bjthemost-hub/l103-drv8316c-joint/gearbox-J/J_ratio25/00_assembly.step

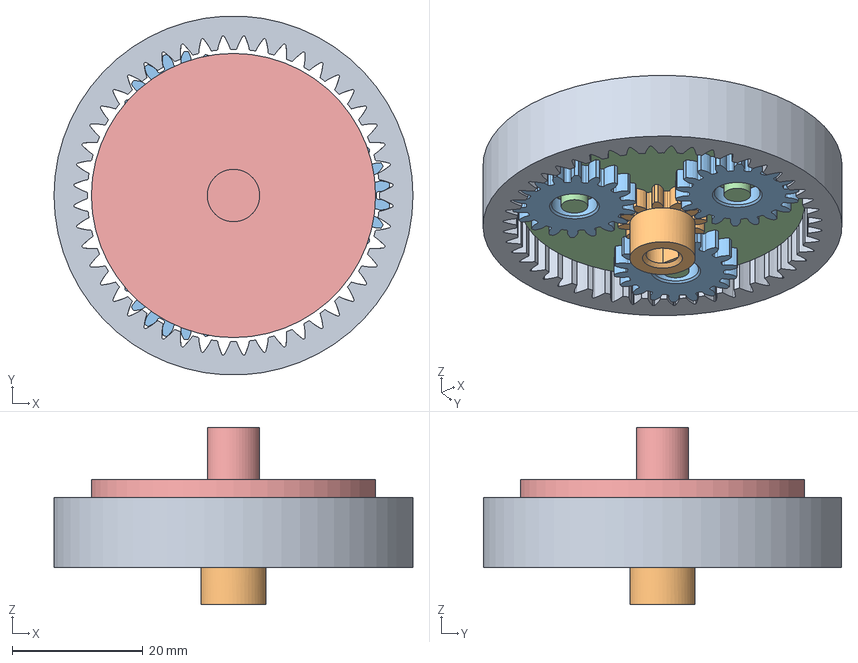
[picture p2: CAD file, 2026-10-27]
gearbox-J/J_ratio25/00_assembly.step
54.8 x 54.7 x 27.1 mm
