bjthemost-hub/l103-drv8316c-joint/gearbox-J/J_ratio25/03_input_sun.step

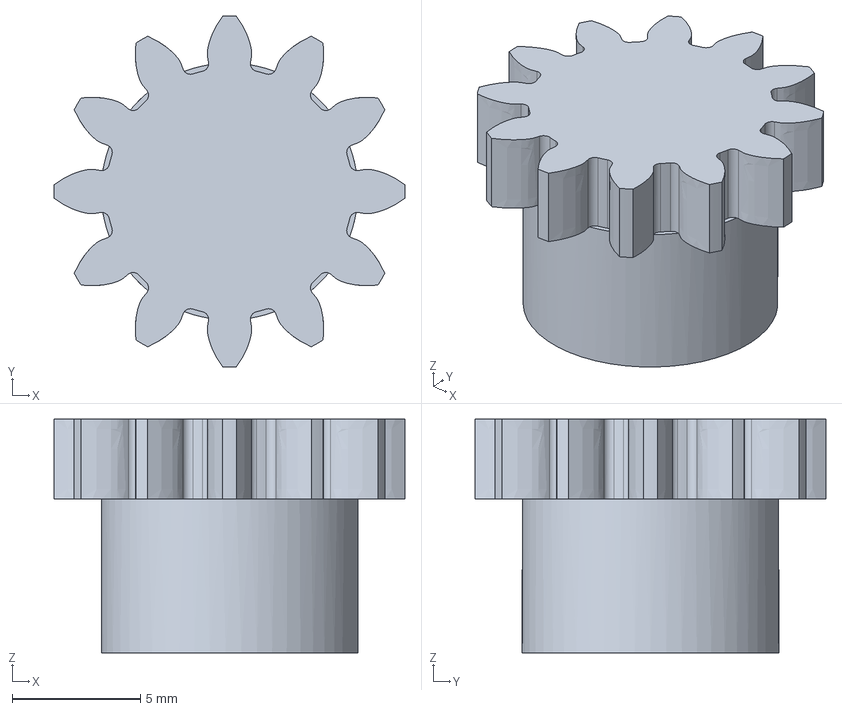
[picture p3: CAD file, 2026-10-27]
gearbox-J/J_ratio25/03_input_sun.step
13.7 x 13.7 x 9.10 mm
