bjthemost-hub/l103-drv8316c-joint/gearbox-J/J_ratio25/02_planet_gear.step

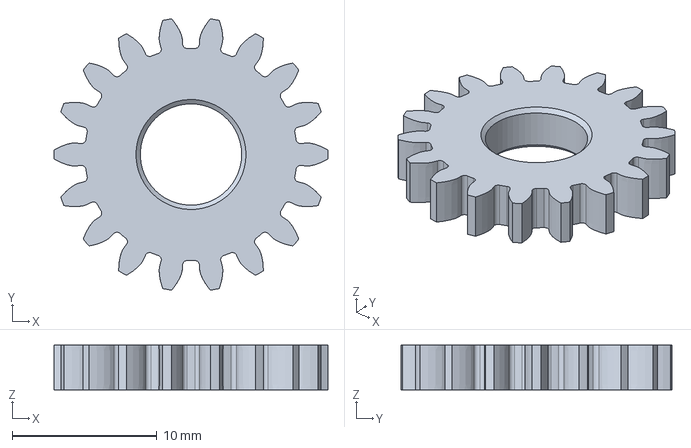
[picture p4: CAD file, 2026-10-27]
gearbox-J/J_ratio25/02_planet_gear.step
18.9 x 18.7 x 3.10 mm
