bjthemost-hub/l103-drv8316c-joint/gearbox-J/J_ratio25/01_ring_gear.step

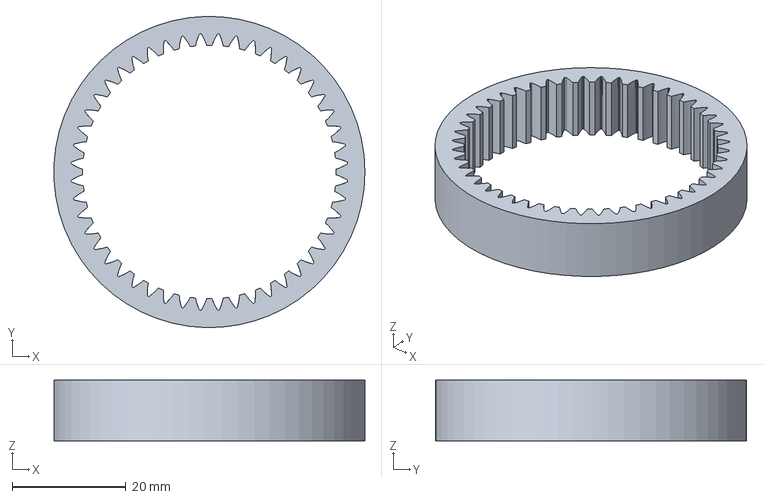
[picture p5: CAD file, 2026-10-27]
gearbox-J/J_ratio25/01_ring_gear.step
54.8 x 54.8 x 10.7 mm
