bjthemost-hub/l103-drv8316c-joint/gearbox-J/J_ratio25/05_output_carrier.step

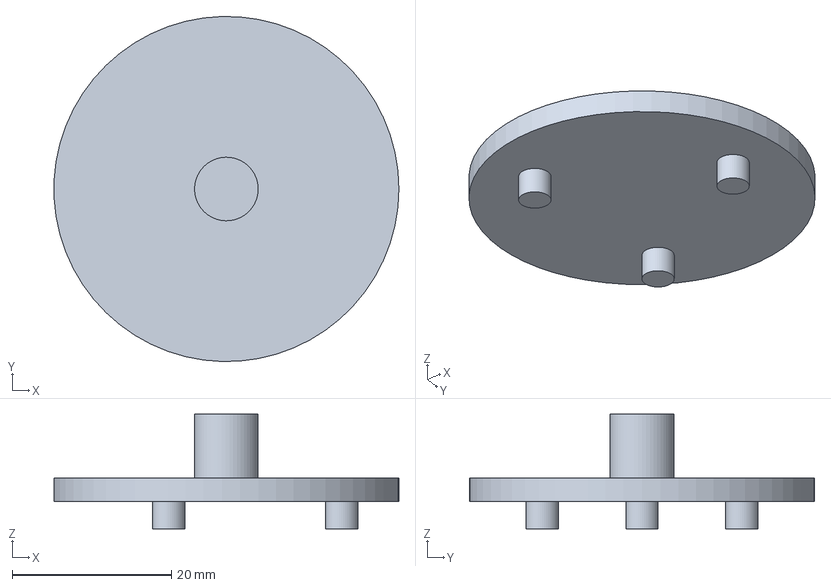
[picture p7: CAD file, 2026-10-27]
gearbox-J/J_ratio25/05_output_carrier.step
43.4 x 43.4 x 14.4 mm
