bjthemost-hub/l103-drv8316c-joint/docs/低速FOC调试方法与坑_2026-10-18.md

# 低速 FOC 调试方法与坑

**L103 + DRV8316C FOC V2 实战记录｜2026-10-18**

> **给谁看**：接下来要调另外 3 款驱动板的人（也可能是三个月后的自己）。
> **怎么用**：先看 §0 和 §10；动手照 §4 的顺序走；卡住了查 §7 的坑表。
> **可信度**：文中每个数字都来自 `firmware/CH32L103_DRV8316C_FOC_V2/work/` 下的原始采样 log，
> 用 `scripts/` 里的脚本可以原样复算（索引见 §11）。
> **一句话**：低速"顿"这次不是靠调 PID 蒙出来的，是**把 MT6701 的原始计数当尺子**量出来的。
> 尺子一立，根因（速度环吃错了反馈）20 分钟就露出来了。

---

## 0. 结论先行（3 分钟读完这段就够开工）

**这块板的成绩**（MT6701 原始计数，稳态段）：

| 给定 | 实测 | 100 ms sd | 100 ms 峰峰 | 零位移采样 | 回退 | 判定 |
|---|---|---|---|---|---|---|
| 3.8 rpm | 3.8 | 13.8% | 52.5% | 8.2% | 9 | 勉强，能看不能交 |
| 6.7 rpm | 6.6 | 14.5% | 47.5% | 2.1% | 1 | 勉强 |
| 10 rpm | 10.0 | 9.6~10.9% | 42.5% | 0.3~0.6% | 0 | **可用**（纹波大但不断流） |
| 30 rpm | 30.0 | 1.8~2.1% | 8.3~9.5% | 0% | 0 | 干净 |
| 60 rpm | 60.0 | 2.1% | 7.5% | 0% | 0 | 干净 |
| 100 rpm | 100.0 | 0.9~1.1% | 3.2~4.3% | 0% | 0 | 干净 |
| 200 rpm | 200.0 | 0.3% | 1.1% | 0% | 0 | 干净 |
| 300 rpm | 300.0 | 0.1~0.2% | 0.5~0.6% | 0% | 0 | 干净 |
| 500 rpm | 499.8 | 0.2% | 0.6% | 0% | 0 | 干净 |
| 700 rpm | 700.0 | 0.2% | 0.8% | 0% | 0 | 干净 |

**30 rpm 是分水岭**：≥30 rpm 全部干净；10 rpm 可用但纹波 40% 峰峰；<7 rpm 开始出现零星回退。

**三条纪律**（违反任何一条，这轮工作就白做）：

1. **判平滑只能用传感器原始数据**，不能用固件里的 `vel` —— 那是估计值，它坏了照样显示得像在工作。
2. **每次只改一个变量**：反馈源 → PLL 带宽 → 速度环 kp → ki，按这个顺序，别一起改。
3. **数字要留下**：每组参数存一份原始采样 log，文件名带转速+时长+反馈源。事后能拿同一套脚本复算。

---

## 1. 基线配置（新板从这套起步，但 §9 里写着哪些不能抄）

| 项 | 本板取值 | 怎么定的 |
|---|---|---|
| 速度反馈源 | **只用 PLL**（`vel_src=1`，命令 `VS1`） | 20 ms 窗口那一路把"停→冲"的阶梯喂给速度环，见坑 3 |
| PLL 带宽 | **150 Hz**（`PB150`） | 40/70/150/220/300 逐档量，见 §6.2 |
| 速度环 `kp` | **0.05 A/(rad/s)** | 0.02→0.04→0.05→0.06→0.07 扫，0.07 直接发散 |
| 速度环 `ki` | **4.0 A/(rad/s·s)** | 0.2→0.5→1→2→3→4→6→8 扫，6 开始重回退，8 发散 |
| 电流上限 `L` | 1.0 A | 家人定的工况：峰值 1.9 A 只是标称，秒级不进超过 1 A |
| 相电阻 `CUR_R_OHM_DEF` | 4.2 Ω | 3.0 V 稳态相电流 0.71 A 反算 |
| 对齐电压 | 3.0 V | 1.5 V 只挪 0.01 rad（不够），4.0 V 已 0.96 A（太贴上限） |
| 极对数 | **11**（MY-4621F，24N22P = 22 极 = 11 极对） | `Q` 里 `pp=11`；`T` 两次做差反推也核过 |
| 母线 | 24 V | —— |

**开环 vs 闭环对照（同一台机、同一转速 10 rpm）**：

| 跑法 | 每 100 ms 位移 | 零位移采样 | 回退 |
|---|---|---|---|
| 开环 1.833 Hz（跳闸前那 1.2 s） | 242~307 count（8.86~11.24 rpm） | 3.8% | 0 |
| 闭环 最终参数 | —— | 0.3~0.6% | 0 |

**读法**：闭环现在**比开环还干净**。这条对照很关键 —— 它证明电机、编码器、驱动、机械都没问题，
后面再怀疑就只能怀疑环路。

---

## 2. 为什么必须用原始计数当尺子（本次最大的收获）

### 2.1 `vel` 会骗人，而且骗得很像真的

修之前，`?` 里的 `vel` 显示 1.0~1.15 rad/s，看着稳；**实际原始位置是走走停停**：

同一段 10 rpm 记录（`work/cap10_p02k20.log`，4.98 s，2497 个 2 ms 样本）：

- **56.0% 的 2 ms 采样零位移**（相邻两个样本 raw 计数完全一样）
- **145 次回退**（2 ms 计数差 < 0，即真的往回走了）
- 100 ms 窗口速度在 **-1.8 ~ +8.1 rad/s** 之间甩
- 100 ms 窗口 sd = 1.19 rad/s，相对 9.0 rpm 的均值是 **126.5%**

`vel` 之所以看着正常，是因为它是 PLL/窗口算出来的**估计值**：PLL 在"停-冲"之间照样能输出一条平滑曲线。
估计值坏了不会报错，只会让你以为已经调好了。

### 2.2 开环对照：这一步别省

同一台机、开环 1.833 Hz 跑 10 rpm（`work/cap10_ol1833.log` 的前 600 个样本 = 1.2 s）：

- 零位移 3.8%（600 个采样里 23 个）
- 回退 0 次
- 2 ms 计数差分布：`0:23 1:24 2:13 3:22 4:61 5:111 6:138 7:129 8:62 9:15 10:1`
  —— 峰在 5~6，两边递减，是正常的样子

**同一台机、开环干净、闭环顿** → 锅在环路，不在齿槽、不在摩擦、不在驱动。
没有这个对照，很容易把问题归到"电机齿槽大 / 机械有摩擦"，然后白折腾一天。

⚠ 这份 log 很容易被误读：**整段**打分是 76.5% 零位移、1 次回退 —— 因为开环跑到 1.2 s 时过流跳闸了，
后面 3.8 s 电机是停的。**必须只取跳闸前那段**。这就是 §3.4 口径问题的活教材。

### 2.3 量化地板：低速端的 sd 有一个算得出来的下限

编码器 14 位 = 16384 count/圈，采样 2 ms：

```
1 count / 2 ms = (2π/16384) / 0.002 = 0.1917 rad/s = 1.83 rpm
```

也就是说，**低速端的"1 个 count 抖动"本身就有 1.83 rpm 的份量**。
10 rpm 时这一份就占 18%，再怎么调 PID 也压不掉 —— 想再往下走，只能提高采样率或换更细的编码器，
不是靠加增益。（这是算术，不是实测。）

这解释了 §0 表里 10 rpm 的 9~11% sd 为什么怎么调都下不去：**分母太小了**。
实测也能对上：10/100/300 rpm 的**绝对** sd 都在 0.11 rad/s 上下，10 rpm 时占 11%、300 rpm 时只占 0.4%。

---

## 3. 尺子怎么架（这套工具建议原样搬到新板）

### 3.1 固件侧：500 Hz 原始角直出（命令 `SD1`）

在**编码器更新**里每 20 帧抽一个 14 位原始计数（10 kHz / 20 = **2 ms**），主循环按
`<seq>,<raw>`（两个十六进制）发出去。**不经过 PLL、不经过窗口测速、不做任何滤波。**

- 开关：`SD1` 打开 / `SD0` 关闭
- 格式：`<seq 12 位>,<raw 14 位>`，每行一个样本，`\r\n`，例：`FA9,1F90`
- 实测体积：1999 个样本 = 19114 字节 → **约 9.6 B/样本，4.8 KB/s**
  （115200 8N1 = 10 bit/字节 ≈ 11.5 KB/s，占用约四成，够用）
- `seq` 是**必须的**：主循环跟不上会丢样，`seq` 跳变立刻暴露，不会把丢样误当成"速度突变"
  - ⚠ `seq` 只有 12 位，**会回绕**（0xFFF → 0x000）。判丢样要按 `(后-前) mod 4096` 算，别直接相减。

实现要点（见 `firmware/CH32L103_DRV8316C_FOC_V2/User/enc.c` 的 `cap_*`）：

1. 捕获点放在 **CRC 校验通过之后** —— 坏帧不进流，否则会把坏帧当作真实抖动。
2. 抽取计数放在**编码器更新里**，不要放主循环 —— 主循环会被 printf 拖慢，节拍就不准了。
3. 主循环只做"有新样本就打印"，不排队、不缓存，丢就丢 —— `seq` 会告诉你丢了多少。
4. 开 `SD` 时先 `SD0` 清一次，避免上一次的残留在缓冲里。
5. **别在 SD1 期间发别的命令**：命令回显会混进数据流，解析会多出杂行（脚本已按正则只认 `hex,hex`）。

### 3.2 上位机侧：一条命令 = 一次测量

```powershell
cd firmware\CH32L103_DRV8316C_FOC_V2
# 给定 1.047 rad/s (=10 rpm), 采 5 s, 存 work\m10.log; 默认测完自动 M0
powershell -ExecutionPolicy Bypass -File scripts\measure.ps1 -Vel 1.047 -Ms 5000 -Out work\m10.log
python scripts\scorecap.py work\m10.log
```

`measure.ps1` 干的事：开串口 → （可选）补发 `-Pre "PB150;S0.05,4.0"` → `SD0` → `V<速度>` → `M3`
→ 等 `-SettleMs`（默认 900 ms）→ `SD1` → 截 `-Ms` → `SD0` → `M0` → 落盘。

⚠ 本机 PowerShell 的执行策略挡住了 .ps1，一律用 `powershell -ExecutionPolicy Bypass -File ...`。

**特别提醒**：`-SettleMs` 只等你 900 ms，**不要把这个数当成"已经稳了"**，
打分默认取尾部（见 §3.4）就是为了避开这段。

### 3.3 四个指标 + 判据

| 指标 | 为什么看它 | 好 / 坏 |
|---|---|---|
| **零位移采样占比** | 直接反映"停没停" | <1% 好；>10% 就是顿 |
| **回退次数**（2 ms 计数差 <0） | 抖到倒转 | 0 次才算干净 |
| **100 ms 窗口速度 sd / 峰峰** | 中频纹波 | sd<2% 好；低速端 >10% 常见 |
| **2 ms 计数差分布** | 看台阶 | 应集中在中位数附近，两边递减 |

单个样本的 2 ms 计数差分布是最能说明问题的一张表：正常是"钟形"，一压增益就变成"0 一堆 + 大数一堆"。

### 3.4 口径三条（这三条踩过，别重踩）

1. **别把爬升段算进指标**。同样 10 rpm：含爬升的 6 s 记录 sd 37.5%，只取后 4 s 稳态是 10.9%。
   `scorecap.py` 取后 5 s，`cmp_tail.py` 默认取尾部；要精确控制就 `python scripts\score_seg.py <log> <起> <止>`。
2. **跳闸/掉线的尾巴会把整段毁掉**。开环那次整段 76.5% 零位移，前 1.2 s 其实只有 3.8%。
   看到离谱的数字，先 `python scripts\trace100.py <log>` 每 100 ms 打印一行，肉眼扫一遍。
3. **文件名带转速+时长+反馈源**。本次 `caponly.ps1` 写死输出名，第二次抓 10 rpm 把第一份覆盖了。
   现在统一用 `-Out work\<含义>.log`。

**脚本清单**（都在 `firmware/CH32L103_DRV8316C_FOC_V2/scripts/`）：

| 脚本 | 用途 |
|---|---|
| `measure.ps1` | 一次测量（定速→M3→SD1→截 N ms→停） |
| `ser.ps1` | 裸串口发命令看回显，例：`-Cmds "?;Q;" -Ms 700` |
| `scorecap.py` | 一次出全部指标（尾部 5 s） |
| `cmp_tail.py` | 多文件对比：25/50/100 ms 三档 + 主导脉动频率 |
| `score_seg.py` | 指定样本区间打分（含 2 ms 差分布） |
| `analyze_cap.py` | 通读：丢样数、总位移、计数差分布 |
| `trace100.py` | 每 100 ms 一行，肉眼看波形 |
| `rndrun.ps1` | 随机转速 × 随机时长批量跑 |
| `trialcap.ps1` | 按 `反馈源:kp:ki[:PLL带宽]` 逐组跑并落盘 |
| `sweepcap.ps1` | kp/ki 组合扫描 |

---

## 4. 调试顺序（新板第一次上电就照这个走）

**第 0 步之前先量三个数**，它们决定后面的天花板：编码器分辨率（CPR）、极对数、母线电压、
相电阻（用直流注入法量）。这几个数不知道，后面所有"调不好"都无从判断。

1. **桥断电**：`CZ` 标三相电流零点（此时不许出力）。
2. **电流符号/相序**：`CS<0|1|2>,<±1>` 只在实测错的时候改；三相电流和 `sum` 应≈0。
3. **编码器自检**：`Q` 看 `err=0 crc=0`；手转一圈看 `raw` 连续、`pp` 对不对。
4. **极对数**：`PP<n>`；不放心用 `T` 两次做差反推。错了对齐全废。
5. **对齐**：`A`，看 `al=1`；对齐电压从 3.0 V 起（本板）。
6. **开环第一步**（家规：上板第一步一律开环）：`R<volt>,<hz>`，从 **0.2~0.5 Hz** 起。
   - 用 `SD1` 量一遍平滑度，**记下这台机的"机械天花板"基线**（本板 10 rpm：零位移 3.8%、回退 0）
   - ⚠ 开环电压给高了会**真实过流跳闸**（本板 3.0 V / 1.83 Hz 跑到 1.2 s 时 `flt=1`）；`X` 清故障
7. **速度环**：`VS1` → `PB150` → `S0.05,0.50` 起步 → 按 §1 的顺序加到 `ki=4.0`
8. **扫速**：10 / 30 / 100 / 300 / 700 rpm 各跑 3~5 s，全部用 `SD1` 打分
9. **看电流**：`iq` 峰值和 `imax` 都要远低于 1 A

**命令语义（已核源码，别凭上一块板的记忆发）**：

- `M0`=OFF `M1`=ALIGN `M2`=TORQUE `M3`=VELOCITY `M4`=POSITION `M5`=OPENLOOP
- `V` 给 **rad/s**；`W` 是速度上限（**会偷偷夹给定**）
- 位置模式要**先进 `M4` 再发 `P`**（切模式会把 `pos_cmd` 改写成当前位置）

---

## 5. 这次实际怎么走过来的（流水账，按时间）

时间为 `work/` 下脚本与 log 的文件时间戳（不是对话时间）。**这段是最值钱的**：
它说明"调不动"的时间里，大部分根本不是 PID 的问题。

| 时间 | 干了什么 | 看到什么 | 结论 / 教训 |
|---|---|---|---|
| 14:08~14:37 | 备份 `csense.c`/`enc.c`，做 NOP 实验，反汇编，首次烧写 | —— | 先把"改前的样子"存下来，后面每一步都能回退 |
| 15:14~15:35 | 备份 `board.h`，用 Python 写定点模型（`model_foc_fx2/3.py`）算增益余量 | —— | **先算再试**：定点位宽/溢出边界在 PC 上算清楚，别拿板子试 |
| 15:45~15:59 | `clk.ps1`/`baud.ps1`/`pp*.ps1`/`rate*.ps1` 核时钟、串口速率、极对数 | 串口 460800 不稳，退回 115200 | 下载器自带 UART 到不了 460800（见坑 16） |
| 16:02~16:24 | `patch_cc4`/`cssign`/`qdir`/`alignwatch`/`olspin`/`spdwatch`/`tqprobe`/`tqt` | 对齐、开环、力矩逐个探 | 每个功能单独一个小脚本验证，别一锅端 |
| 16:30~16:42 | `patch_span`/`patch_win`/`fix_coef`/`guard.ps1` | —— | 加了"护栏"脚本，跑实验前先确认状态 |
| 16:49~16:57 | 加原始捕获流 + **修 PLL 无符号除法**（`fix_pll_unsigned.py`） | 修前：一使能 `pos` 狂涨、`th` 几乎不动 | 坑 1 |
| 17:00~17:04 | **速度环积分器 Q12→Q16**（`fix_spd_integ.py`）+ 落默认值 + `bench_*` 四组 | 修前：给速度，`iq` 只有 0.01 A，电机纹丝不动 | 坑 2 |
| 17:06~17:08 | `sw10_*` kp/ki 扫描（此时还是窗口反馈） | 怎么调都是"走-停"，降到 kp0.005 也只是变慢 | 直觉是"增益不够"，其实是**反馈源坏了** |
| 17:10~17:13 | 加 `SD1` 原始角直出（`patch_cap.py`）+ `cap10_p02k20` / `cap10_ol1833` | 闭环 56.0% 零位移 / 145 回退；开环 3.8% / 0 回退 | **尺子立起来**，锅锁定在环路 |
| 17:13~17:15 | 加 `VS`/`PB` 在线切换（`patch_vsrc.py`），`vs10_*` / `pb10_*` | `VS2` 窗口：-0.48 rpm、938 回退；`VS1` PLL：9.82 rpm、0 回退 | **根因确认**（坑 3） |
| 17:16~17:19 | `r10*` / `r30*` / `r100*` / `k30*` / `k100*` ki 扫描 | ki 4.0 最优；6 开始重回退；8 发散 | 定 `ki=4.0`（§6.3） |
| 17:20 | `final_10/30/100` 复测 | 三档全干净 | 落默认值 |
| 19:39~19:46 | `cap_v045/300/700` + `rnd_*` 随机 12 段 | 全档位、随机时长复测 | 交卷 |

**一句话**：从 14:00 到 17:10 都在修**上电就错**的东西（PLL 除法、积分器精度、反馈源），
真正的 PID 调参只有 17:16~17:20 **四分钟**。下次先照 §4 的顺序把"地基"验一遍，
不要一上来就调 PID。

---

## 6. 参数扫描全表（全部可复算）

口径统一：`scorecap.py` 取**尾部 5 s**；`sd100` 是 100 ms 窗口速度的**绝对**标准差（rad/s）。
"sd100 %"= 绝对 sd ÷ 该段平均速度。

### 6.1 反馈源（10 rpm，kp0.02 / ki0.20 / PB150）

| 反馈 | 平均 rpm | 零位移 | 回退 | sd100 | 判定 |
|---|---|---|---|---|---|
| `VS2` 只窗口 | **-0.48** | 12.6% | **938** | 10.94 | 完全不行（均值都拉负了） |
| `VS1` 只 PLL | 9.45 | 22.3% | 0 | 0.72 | 不顿，但增益太小跟不上 |
| `VS1` + kp0.05/ki0.50 | 9.82 | 2.3% | 0 | 0.31 | 可调 |
| `VS1` + kp0.10/ki1.00 | 0.13 | 0.2% | **1256** | 0.53 | 增益过大，直接失速 |

### 6.2 PLL 带宽（10 rpm，kp0.05 / ki0.50）

| `PB` | 平均 rpm | 零位移 | 回退 | sd100 |
|---|---|---|---|---|
| 40 | 9.94 | 16.1% | 537 | 0.55 |
| 70 | 9.96 | 4.7% | 86 | 0.29 |
| **150** | 9.90 | **0.3%** | **0** | 0.30 |
| 220 | 9.85 | 0.1% | 0 | 0.31 |
| 300 | 9.95 | 0.1% | 0 | 0.30 |

**读法**：70 以下明显退化；**150 已经到位**；220/300 回退是 0 但 sd 没再降 —— 多给的带宽不换收益，
反而更容易把噪声引进环路。所以取 150 留余量。

### 6.3 ki 扫描（10 rpm，PB150）

| kp / ki | 平均 rpm | 零位移 | 回退 | sd100 | 备注 |
|---|---|---|---|---|---|
| 0.04 / 1.0 | 9.91 | 0.2% | 0 | 0.33 | |
| 0.06 / 0.8 | 9.91 | 0.2% | 0 | 0.26 | |
| 0.05 / 0.5 | 9.82 | 2.3% | 0 | 0.31 | 起点 |
| 0.05 / 1.0 | 10.02 | 0.0% | 0 | 0.26 | |
| 0.06 / 1.2 | 9.91 | 0.8% | 0 | 0.24 | |
| 0.05 / 1.5 | 10.00 | 0.0% | 0 | 0.21 | |
| 0.05 / 2.0 | 9.97 | 0.0% | 0 | 0.19 | |
| 0.05 / 3.0 | 9.93 | 0.2% | 0 | 0.15 | |
| **0.05 / 4.0** | 9.99 | 0.5% | **0** | **0.11** | **落这档** |
| 0.05 / 6.0 | 9.94 | 5.3% | **176** | 0.08 | sd 更好但**开始重回退** |
| 0.05 / 8.0 | 9.16 | 7.0% | **855** | 0.63 | 发散 |

**这张表里最重要的一行是 ki=6.0**：它的 sd（0.08）比 4.0（0.11）**还小**。
只盯 sd 会选错 —— **必须同时看回退次数**。低频抖动被压平了，代价是每 2 ms 里有零星倒转。

### 6.4 换转速交叉验证（30 / 100 rpm）

| 转速 | ki0.5 | ki2.0 | ki4.0 |
|---|---|---|---|
| 30 rpm sd100 | 0.17 | 0.08 | **0.06** |
| 100 rpm sd100 | 0.18 | 0.15 | **0.11** |

ki=4.0 在 30 和 100 rpm 上也是最优 —— 说明这个值不是为 10 rpm 单独凑出来的。

### 6.5 kp 的上边界（10 rpm，PB150）

| kp / ki | 平均 rpm | 零位移 | 回退 | 判定 |
|---|---|---|---|---|
| 0.05 / 0.35 | 9.79 | 2.6% | 1 | 积分不足 |
| 0.05 / 0.70 | 9.90 | 2.9% | 7 | 积分不足 |
| 0.06 / 0.50 | 9.93 | 5.0% | 64 | kp 偏大 |
| **0.07 / 0.60** | **-0.47** | 8.5% | **937** | **发散** |

kp 的边界很窄：0.06 已经能看出退化，0.07 直接翻车。**调的时候一次只加 0.01。**

### 6.6 随机复测 12 段（整段口径，含爬升）

| 文件 | 给定 | 实测 | 时长 | 零位移 | 回退 | sd100 | 峰峰 |
|---|---|---|---|---|---|---|---|
| rnd_12 | 3.8 rpm | 3.8 | 1.61 s | 8.2% | 9 | 13.8% | 52.5% |
| rnd_11 | 6.7 | 6.6 | 3.54 s | 2.1% | 1 | 14.5% | 47.5% |
| rnd_09 | 10 | 10.0 | 4.61 s | 0.3% | 0 | 9.6% | 42.5% |
| rnd_10 | 30 | 29.9 | 2.29 s | 0% | 0 | 2.1% | 8.7% |
| rnd_03 | 30 | 30.0 | 3.11 s | 0% | 0 | 2.1% | 9.5% |
| rnd_01 | 60 | 60.0 | 3.62 s | 0% | 0 | 2.1% | 7.5% |
| rnd_05 | 100 | 100.0 | 2.96 s | 0% | 0 | 0.9% | 3.2% |
| rnd_04 | 200 | 200.0 | 4.58 s | 0% | 0 | 0.3% | 1.1% |
| rnd_07 | 300 | 299.8 | 2.22 s | 0% | 0 | 0.1% | 0.5% |
| rnd_08 | 300 | 300.0 | 4.82 s | 0% | 0 | 0.2% | 0.6% |
| rnd_06 | 500 | 499.8 | 2.56 s | 0% | 0 | 0.2% | 0.6% |
| rnd_02 | 700 | 700.0 | 4.92 s | 0% | 0 | 0.2% | 0.8% |

同一转速跑两个不同时长（30 rpm 2.29 s / 3.11 s、300 rpm 2.22 s / 4.82 s），结果一致 —— 可复现。

---

## 7. 坑（症状 → 怎么定位 → 根因 → 修法 → 新板怎么预防）

> 前三条是**会让人调一整晚**的；每条都写了"换板时凭什么能提前发现"。

### 坑 1：PLL 预测步长用了无符号除法（最隐蔽）
- **症状**：静止一切正常，一使能 `pos` 狂涨、`th` 几乎不变。
- **定位**：`pos` 在涨但电角度不动 → 直接去看 PLL 那几行，把中间量打出来看符号。
- **根因**：`ENC_TICK_HZ` 是 `unsigned`，`pll_vel_q24 / ENC_TICK_HZ` 整段变成**无符号除法**；
  速度为负时除法结果反向，位置每拍跳 +0.0256 圈，PLL 速度被推到 ±128 圈/s 的天花板。
- **修法**：整段改 `int64`，除数写成 `(int32_t)ENC_TICK_HZ`；两处 PLL 校正乘法也改 `int64`
  （`err` 钳到 2^18 时 int32 会溢出）。
- **新板预防**：把 PLL 的三行拿计算器代几个负数进去算一遍。**混合有符号/无符号的除法是静默炸弹**。

### 坑 2：速度环积分器精度不够，电机干脆不动
- **症状**：给速度，`vel` 一直是 0，`iq` 只有 0.01 A 左右，电机纹丝不动。
- **定位**：`iq` 有值但极小 → 说明环路在算，只是算出来不够大 → 查积分器位宽。
- **根因**：积分器用 Q12，`ki*ts` 每拍增量被右移截成 0（`ki=0.3` 时 5 s 后 `iq` 仍 0.01 A）。
- **修法**：积分器 Q12 → **Q16**，输出 `>>4`。
- **新板预防**：定点化时**先算"最小增量还剩几个 LSB"**，别等现场怀疑电机坏了。

### 坑 3：低速用 20 ms 窗口测速当反馈，速度环只能压到很低，一压就"走走停停"（本次主犯）
- **症状**：10 rpm 时 56.0% 采样零位移、145 次回退；把增益降下来只是把"冲"变小，"停"还在。
- **定位**：加 `VS0/1/2`（自动/PLL/窗口）**在线切换**，同一台机同一转速对打：
  `VS2` 窗口 = -0.48 rpm / 938 回退；`VS1` PLL = 9.82 rpm / 0 回退。
- **根因**：窗口值 20 ms 才更新一次（ZOH 再加 20 ms 延迟），还被 0 计数台阶拉低；
  速度环看见的是"停→冲"的阶梯，只能把 kp 压到 0.02、ki 压到 0.2 —— 压低了就必然顿。
- **修法**：速度环默认只用 PLL（`vel_src=1`），窗口只留作诊断。
- **新板预防**：**先量反馈通路的延迟和量化，再调 PID**。延迟决定你能用多大增益，不是反过来。

### 坑 4：`W`（速度上限）在偷偷夹你
- **症状**：`V31.416` 回 `OK vel_cmd=31.416`，但 `ref vel` 一直是 1.05，转速上不去。
- **根因**：之前为了跑 200 圈设了 `W1.047`，速度环把给定夹到 `vel_limit`，**回显不提示**。
- **修法**：`W330`（或按需）放开；调高速前**先看 `ref vel` 是不是等于给定值**。
- **新板预防**：所有"回显正确但行为不对"的，先怀疑**另一个隐形的上限**（限流/限速/限位）。

### 坑 5：位置模式一切进去就把目标改成"当前位置"
- **症状**：先 `P<目标>` 再 `M4`，位置环进去了但一动不动，`ref vel=0`。
- **根因**：运行中切模式时，`motor.c` 里把 `pos_cmd = 当前角度`（防跳变的安全设计），
  把你刚发的目标**覆盖**了。
- **修法**：**先进 `M4`，再发 `P<目标>`**。
- **新板预防**：换板先看一遍"切模式"那段代码 —— 那里一定藏着会吃掉你给定的逻辑。

### 坑 6：模式编号跟老固件不一样
- **本板**：`M0`=OFF、`M1`=ALIGN、`M2`=TORQUE、`M3`=VELOCITY、`M4`=POSITION、`M5`=OPENLOOP。
- **老固件（CH32L103_DRV8313）**：`M0` 力矩 / `M1` 速度 / `M2` 角度 / `M3` 速度开环 / `M4` 角度开环。
- **教训**：**发 `M<n>` 前先看 `mode_name()` / 枚举**，别凭上一块板的记忆发。本次就误发过一个 `M2`（力矩）。

### 坑 7：开环电压给高 → 真过流跳闸，别误判成硬件坏
- **症状**：开环跑 1.2 s 后突然停住，`flt=1/1`、`mode=OFF`。
- **根因**：`MOTOR_OC_TRIP_A=2.0` 触发，`latch_fault` 关桥。
- **修法**：`X` 清故障；开环用更低电压/更短时间做对照。
- **教训**：**开环不是"安全模式"**，它一样能烧东西；开环只看"能不能转、平不平"，别久跑。

### 坑 8：`?` 里的 `vel` 会骗人
- 见 §2.1。**永远用原始计数交叉验证**，至少在做"平滑度"结论的时候。
- 补充：**同一路反馈不算独立证据**。PLL 值和窗口值"吻合"证明不了位置对，因为两者同源。

### 坑 9：诊断计数器是"自上次清零以来"的
- `Q` 里的 `recon`、`csync`、`enc frames` 是累计量；跑过高速之后再去跑低速，这些数会把两段混在一起
  （本次出现过 `recon=167787` 被误读）。
- **修法**：要对比就先复位，或者只信两次 `Q` 之间的**增量**。

### 坑 10：串口 "Access denied" 先查是不是自己的进程没退
- 中断一次批量脚本后，`COM15` 被残留进程占着，第二次打开就 `Access to the port is denied`。
- **做法**：先列 `powershell` 进程确认，别一上来怀疑下载器/板子。

---

### 坑 11：采集窗口含爬升段，指标全假
- **症状**：同一组参数两次打分差 3~4 倍（37.5% vs 10.9%）。
- **根因**：一段 6 s 的记录里前 2 s 是爬升。
- **修法**：`scorecap.py` 默认取尾部 5 s；要不留余地就 `score_seg.py <log> <起> <止>` 自己切。
- **新板预防**：**先 `trace100.py` 看一遍再信指标**。一眼能看出哪段是爬升、哪段是停。

### 坑 12：跳闸/掉线会把整段 log 毁掉
- **症状**：开环 10 rpm 的 log 整段打分 76.5% 零位移，看着像"根本转不动"。
- **真相**：前 1.2 s 只有 3.8%，后面 3.8 s 是跳闸停机。
- **修法**：`trace100.py` 找到停机时刻，用 `score_seg.py` 只取有效段。
- **新板预防**：**每次采集后先看尾部**。尾部长时间 0 就是跳闸或掉线，别拿去比参数。

### 坑 13：采样文件重名，把不同转速的数据混了
- **症状**：回头比"两次 10 rpm"发现结论对不上。
- **根因**：本次 `caponly.ps1` 写死了输出名，第二次抓 10 rpm 时覆盖了 0.45 rad/s 的那份。
- **修法**：文件名带**转速 + 时长 + 反馈源**，例如 `rnd_03_v3.142_3120ms.log`；
  现在统一走 `measure.ps1 -Out work\<含义>.log`。
- **新板预防**：**写死输出名的脚本就是定时炸弹**，第一次用就参数化。

### 坑 14：`seq` 12 位回绕，直接相减会误判成"丢了 4000 个样"
- **症状**：数据流里 `FFF` 后面接 `7C7`，一眼像丢了近 2000 个样本。
- **真相**：`seq` 只有 12 位，0xFFF 之后回绕到 0x000。按 `(后-前) mod 4096` 算才是真丢样数。
- **新板预防**：凡是"序号"字段，先确认位宽和回绕规则，再写丢样检测。

### 坑 15：抽帧放主循环 / 坏帧没滤掉
- **症状**：低速数据看着"抖"，但换一版固件就没了。
- **根因**：主循环里有 printf，节拍被拖；或者 CRC 没过的坏帧也进了流。
- **修法**：抽帧放**编码器更新**里（10 kHz 定时源）；捕获点放 **CRC 通过之后**。
- **新板预防**：尺子本身不准，后面所有结论都是错的。**先证明尺子是直的**：
  静止时 raw 不动、手转一圈 raw 单调、丢样为 0。

### 坑 16：串口 460800 不稳，退回 115200
- **症状**：460800 下偶发乱码 / 收不全。
- **根因**：下载器自带的 UART 口不稳（不是 MCU 的问题）。
- **修法**：固件和上位机都退到 **115200**；`SD1` 的 4.8 KB/s 在 115200 下够用（约四成带宽）。
- **新板预防**：换板第一件事用 `baud.ps1` 之类**打一串固定文本对一遍**，别拿调试链路当示波器。

### 坑 17：`SD1` 期间发别的命令，回显混进数据流
- **症状**：解析脚本报"格式不对"，或者样本数对不上。
- **根因**：`OK ...` 之类的回显和 `<hex>,<hex>` 混在一起。
- **修法**：解析按 `^[0-9A-Fa-f]+,[0-9A-Fa-f]+$` 只认数据行（`scripts/*.py` 已经这么写）；
  采集期间不发别的命令。
- **新板预防**：数据流和回显**共用一个口**时，永远假设它们会打架。

### 坑 18：扫参数扫到"发散"才知道边界在哪
- **症状**：kp 0.06 看着还行，0.07 直接 -0.47 rpm / 937 回退。
- **教训**：**边界必须自己扫出来，不能靠猜**。且**一次只加一档**（kp 步长 0.01，ki 从 2 起步翻倍）。
- **另一个陷阱**：ki=6.0 的 sd 比 4.0 更小，但回退 176 次 —— **sd 单一指标会骗人**（§6.3）。

### 坑 19：母线电压不够，却去调环路
- **症状**：转速上不去，`vq` 顶到 12.7 V 附近然后 nFAULT。
- **真相**：`Ke ≈ 0.083 V/(rad/s)`（由 12.7 V / 153 rad/s 反推），314 rad/s 要 ~26 V，
  24 V 母线上不去 3000 rpm。**这是电压不够，不是环路问题**。
- **新板预防**：换板先算一遍"我这母线最多能到多少 rpm"，把这个数写在纸上贴显示器上。

### 坑 20：低速端的 sd% 天生就大，别拿同一个阈值卡所有转速
- 10/100/300 rpm 的**绝对** sd 都在 0.11 rad/s 上下，但相对值是 11% / 1% / 0.4%。
- **判据要分档**：≥30 rpm 用相对值（<2%）；<30 rpm 用绝对值和零位移占比。
- 根子在 §2.3 的量化地板。

---

## 8. 已知的物理天花板（别再往上撞）

- **24 V 母线到不了 3000 rpm**：跑到 ~153 rad/s 时 `vq` 已顶 12.73 V 并报 nFAULT。
  由 `12.7 V / 153 rad/s` 反推 Ke ≈ 0.083 V/(rad/s)，314 rad/s 约需 26 V。**这里调环路没用，得升母线。**
- **10 rpm 以下有一份 ~0.11 rad/s 的固定速度纹波**：10/100/300 rpm 的绝对 sd 都是 0.11 rad/s 上下，
  10 rpm 时占 11%、300 rpm 时只占 0.4%。要再压得从**转矩脉动**下手（齿槽/角度滞后/电流环），
  继续加 PID 到 `ki=6` 就开始重回退。
- **高转速下 `vd` 会涨**：700 rpm 时 `vd=0.99 V / vq=6.56 V`，折算电角度滞后约 8.6°，
  白吃电流。再往高走要动 PLL 带宽或角度外推。
- **2 ms 采样 + 14 位编码器的量化地板 = 1.83 rpm**（§2.3），低速端所有指标都受它托底。

---

## 9. 换板清单：哪些能抄，哪些必须重测

### 9.1 直接抄（跟具体板子无关）

- **判据与工具链**：`SD` 原始直出 → `measure.ps1` → `scorecap.py` 四指标。整套照搬。
- **调试顺序**：§4 的 9 步。尤其"先开环做机械基线"这一步。
- **反馈源策略**：速度环**只用 PLL**，20 ms 窗口只留作诊断。
- **速度环积分器 Q16**（Q12 在低速会截断成 0）。
- **PLL 里的有符号除法**：整段 `int64`，除数转 `int32_t`。
- **"一次只改一个变量"的顺序**：反馈源 → PLL 带宽 → kp → ki。
- **口径**：尾部取稳态、看 2 ms 计数差分布、文件名带转速。

### 9.2 必须重测（每块板的数都不一样）

| 项 | 为什么不能抄 | 怎么量 |
|---|---|---|
| 速度环 kp / ki | 跟电机电感电阻、母线、电流环带宽、编码器分辨率全有关 | §6.3 / §6.5 的扫法，从 kp0.05 / ki0.5 起 |
| PLL 带宽 | 跟编码器 CPR 和采样率有关；CPR 低的板子给 150 Hz 可能就抖 | 40/70/150/220 各跑一遍 |
| 对齐电压 | 跟相电阻有关；太高直接过流 | 从 3.0 V 试，看转没转 + 电流 |
| 过流阈值 / I2t | 跟功率级和电机额定有关 | 按电机铭牌 + 实测温升 |
| 极对数 | 错了对齐全废 | `PP` + `T` 两次做差反推 |
| 电流零点 / 相序符号 | 每块板的采样电阻和相序都可能不同 | `CZ` + `CS` + 三相电流和≈0 |
| 电压天花板（最高 rpm） | 母线 × Ke 决定 | 升速到 `vq` 顶住或 nFAULT，记下那个点 |

### 9.3 移植时要动的三处代码

1. `User/enc.c` 的 `cap_*`：编码器中断里每 20 帧抽一个 raw，主循环打印 `<seq>,<raw>`。
   **捕获点必须在 CRC 通过之后**，抽帧必须在编码器更新里。
2. `User/enc.c` / `cmd.c`：`vel_src`（`VS0/1/2`）+ PLL 带宽（`PB<hz>`）—— 这两个开关是**调试期最重要的一对**，
   新板一开始就要有，不然又要靠"改固件重烧"来对比。
3. `User/board.h`：速度环默认 `kp/ki`、积分器 Q16。

### 9.4 三块板并行调的时候，别互相污染

- **一个板一个目录**，`work/` 下的 log 用板名/日期前缀，别混。
- 参数扫到一半就换板，**先把当前 log 存盘并把结论写回文档**，否则回来分不清哪组数属于哪块板。
- 每块板都留一份"机械基线"（开环 10 rpm 的零位移/回退），后面吵架时拿它当裁判。

---

## 10. 一页速查（打印出来贴墙上）

```
上电顺序:   CZ 零点 -> Q 查 err/crc -> PP 极对数 -> A 对齐 -> R 开环 0.2~0.5Hz
尺子:       SD1 (500Hz 原始角, 2ms)  |  measure.ps1 -Vel <rad/s> -Ms <ms> -Out work\x.log
打分:       scorecap.py <log>    看: 零位移% / 回退 / sd100 / 峰峰
判据:       >=30rpm: sd100<2%, 零位移<1%, 回退 0
            10~30rpm: 零位移<1%, 回退 0, sd100 看绝对值(~0.11 rad/s 是本板地板)
调参顺序:   反馈源(VS1) -> PLL带宽(PB150) -> kp(0.05 起) -> ki(0.5 起, 翻倍加到回退出现)
停下信号:   ki 一加就出现回退 -> 退回上一档; kp 0.07 级发散
安全:       秒级相电流 <=1A; 开环也会真过流; 位置模式先 M4 再 P
```

**判定一次调试"成了没有"**：零位移 <1%、回退 0、≥30 rpm 时 sd100 <2%。
三条不齐就是没成，别急着说"调好了"。

---

## 11. 证据在哪

- **本轮工作报告**：`firmware/CH32L103_DRV8316C_FOC_V2/docs/工作报告_2026-10-18_低速10-30-100rpm平滑化.md`
- **原始采样**：`firmware/CH32L103_DRV8316C_FOC_V2/work/` 下（**只在本地，不进 git**）
  - 主犯证据：`cap10_p02k20.log`（闭环 56% 零位移）、`cap10_ol1833.log`（开环对照）
  - 反馈源：`vs10_vs2_*`（窗口）vs `vs10_vs1_*`（PLL）
  - PLL 带宽：`pb10_*_pb40/70/150/220`、`r10b_*_pb300`
  - ki 扫描：`r10b/r10c/r10d/r10e_*`
  - 落默认后复测：`final_10/30/100rpm.log`、`cap_v045/300/700.log`、`rnd_01..12_*.log`
- **分析脚本**：`firmware/CH32L103_DRV8316C_FOC_V2/scripts/`（见 §3.4 的表）
- **命令表**：`firmware/CH32L103_DRV8316C_FOC_V2/docs/命令表.md`（含 `SD`/`VS`/`PB`）
- **固件改动**：`User/enc.c`（捕获流 + `vel_src` + PLL 定宽）、`User/enc.h`、`User/cmd.c`（`SD`/`VS`/`PB`）、
  `User/main.c`（直出）、`User/board.h`（`SPD_KP_DEF=0.05`、`SPD_KI_DEF=4.0`）

---

## 变更记录

- **2026-10-18 第一版**：调试完成当天写的骨架（结论表 + 11 条坑）。
- **2026-10-18 第二版（本版）**：为"马上要调另外 3 块驱动板"重写 —— 补 §5 流水账、§6 全部扫描数据、
  §2.3 量化地板、§9 换板清单；坑从 11 条扩到 20 条；脚本统一收进 `scripts/`，新增 `measure.ps1`
  （一条命令一次测量）。
