bjthemost-hub/l103-drv8316c-joint/hardware/L103_DRV8316C.kicad_pcb

## KiCad design hardware/L103_DRV8316C.kicad_pcb (2026-10-27)

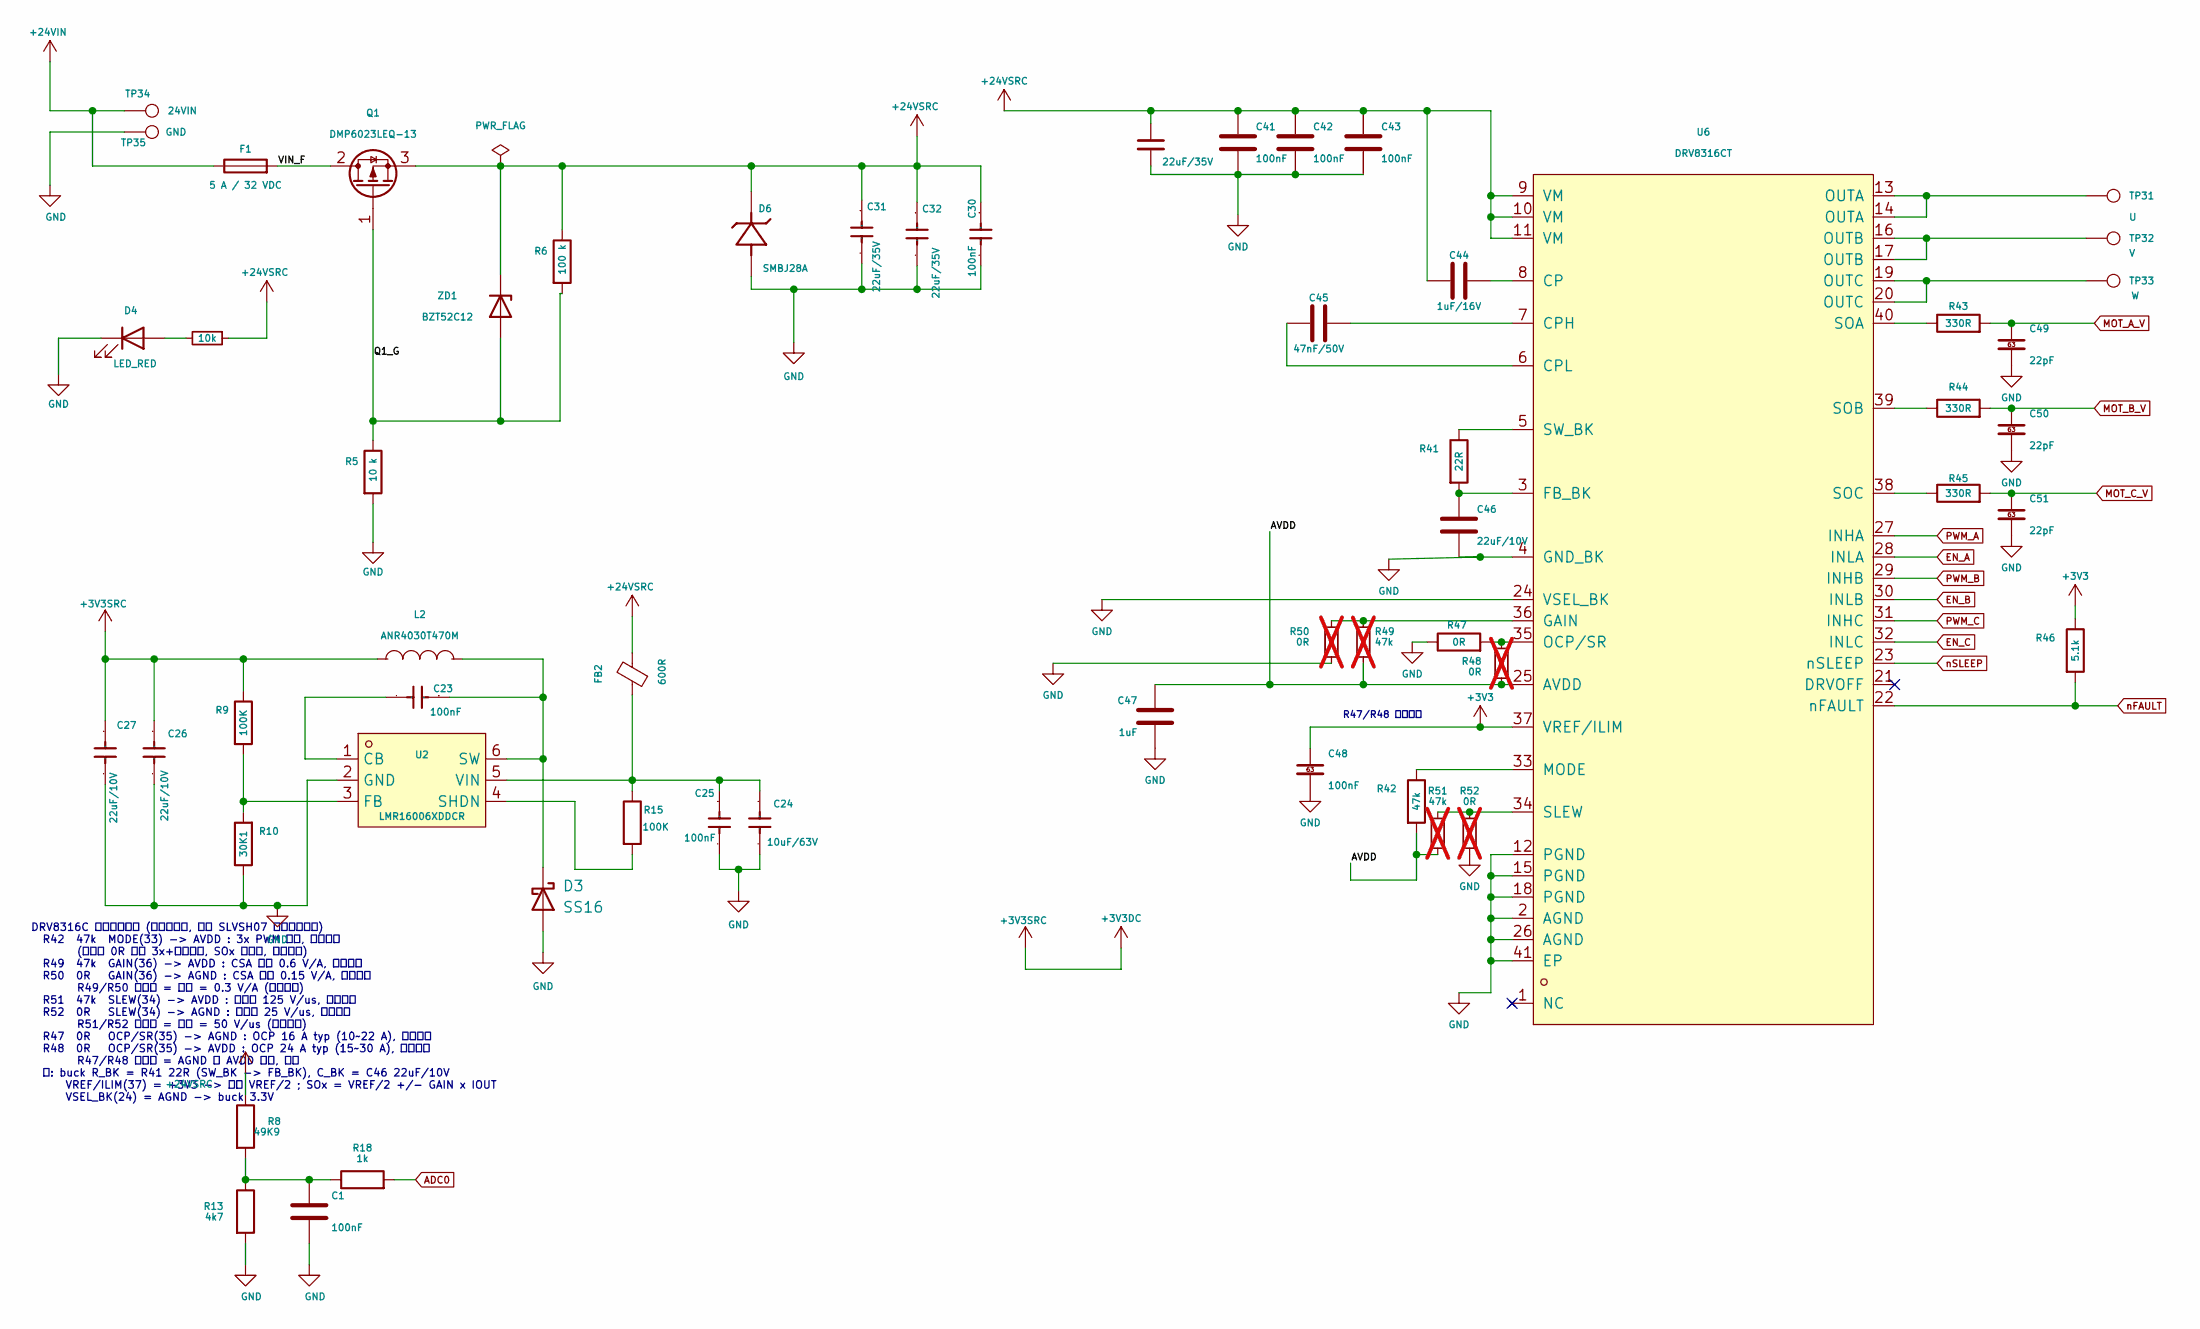
[picture p8: schematic DRV8316C.kicad_sch]

Parts:
C1, C23, C25, C30, C41, C42, C43, C48: 100nF; C_0603_1608Metric
C7, C31, C32: 22uF/35V; C_1206_3216Metric
C24: 10uF/63V; C_0805_2012Metric
C26, C27, C46: 22uF/10V; C_0805_2012Metric
C44: 1uF/16V; C_0603_1608Metric
C45: 47nF/50V; C_0603_1608Metric
C47: 1uF; C_0603_1608Metric
C49, C50, C51: 22pF; C_0603_1608Metric
D3: SS16; D_SMA
D4: LED_RED; LED_0603_1608Metric
D6: SMBJ28A; D_SMB; BREAKDOWN VOLTAGE 28.9V; MANUFACTURER PART SMBJ28A; LCSC PART NAME SMBJ28A
F1: 5 A / 32 VDC; Fuse_Littelfuse-NANO2-451_453
FB2: 600R; L_0805_2012Metric
L2: ANR4030T470M; L_APV_ANR4030; MPN ANR4030T470M; LCSC Part C6364808
Q1: DMP6023LEQ-13; SOT-223-3_TabPin2
R5: 10 k; R_0805_2012Metric
R6: 100 k; R_0805_2012Metric
R8: 49K9; R_0603_1608Metric
R9, R15: 100K; R_0603_1608Metric
R10: 30K1; R_0603_1608Metric
R13: 4k7; R_0603_1608Metric
R18: 1k; R_0603_1608Metric
R25: 10k; R_0603_1608Metric
R41: 22R; R_0603_1608Metric
R42: 47k; R_0402_1005Metric
R43, R44, R45: 330R; R_0603_1608Metric
R46: 5.1k; R_0603_1608Metric
R47: 0R; R_0402_1005Metric
R48, R50, R52: 0R; R_0402_1005Metric; not fitted
R49, R51: 47k; R_0402_1005Metric; not fitted
TP31: U; tp2.2x1.2_th
TP32: V; tp2.2x1.2_th
TP33: W; tp2.2x1.2_th
TP34: 24VIN; tp2.2x1.2_th
TP35: GND; tp2.2x1.2_th
U2: LMR16006XDDCR; SOT-23-6; MPN LMR16006XDDCR; LCSC Part C87080
U6: DRV8316CT; VFQFN-40_L5.0-W7.0-P0.50-TL-EP
ZD1: BZT52C12; D_SOD-123

Connections:
+3V3: C48.1, R46.1, U6.37 (VREF/ILIM); also elsewhere on the board
+3V3DC: C26.1, C27.1, L2.1, R9.1; also elsewhere on the board
+24VIN: F1.1, TP34.1 (1_1)
+24VSRC: C7.1, C30.1, C31.1, C32.1, C41.1, C42.1, C43.1, C44.1, D6.1 (K), FB2.2, Q1.3 (S), R6.1, R8.1, R25.1, U6.9 (VM), U6.10 (VM), U6.11 (VM), ZD1.1 (K)
/DRV8316C/AVDD: C47.1, R42.2, R48.2, R49.2, R51.2, U6.25 (AVDD)
/DRV8316C/Q1_G: Q1.1 (G), R5.1, R6.2, ZD1.2 (A)
/DRV8316C/VIN_F: F1.2, Q1.2 (D)
ADC0: R18.2; also elsewhere on the board
EN_A: U6.28 (INLA); also elsewhere on the board
EN_B: U6.30 (INLB); also elsewhere on the board
EN_C: U6.32 (INLC); also elsewhere on the board
GND: C1.2, C7.2, C24.2, C25.2, C26.2, C27.2, C30.2, C31.2, C32.2, C41.2, C42.2, C43.2, C46.2, C47.2, C48.2, C49.2, C50.2, C51.2, D3.2 (A), D4.1 (K), D6.2 (A), R5.2, R10.1, R13.2, R47.1, R50.2, R52.2, TP35.1 (1_1), U2.2 (GND), U6.2 (AGND), U6.4 (GND_BK), U6.12 (PGND), U6.15 (PGND), U6.18 (PGND), U6.24 (VSEL_BK), U6.26 (AGND), U6.41 (EP); also elsewhere on the board
MOT_A_V: C49.1, R43.2; also elsewhere on the board
MOT_B_V: C50.1, R44.2; also elsewhere on the board
MOT_C_V: C51.1, R45.2; also elsewhere on the board
unnamed: C1.1, R8.2, R13.1, R18.1
unnamed: C23.1, D3.1 (K), L2.2, U2.6 (SW)
unnamed: D4.2 (A), R25.2
unnamed: TP31.1 (1_1), U6.13 (OUTA), U6.14 (OUTA)
unnamed: TP32.1 (1_1), U6.16 (OUTB), U6.17 (OUTB)
unnamed: TP33.1 (1_1), U6.19 (OUTC), U6.20 (OUTC)
unnamed: C23.2, U2.1 (CB)
unnamed: R9.2, R10.2, U2.3 (FB)
unnamed: R15.2, U2.4 (SHDN)
unnamed: C24.1, C25.1, FB2.1, R15.1, U2.5 (VIN)
unnamed: C44.2, U6.8 (CP)
unnamed: C45.2, U6.7 (CPH)
unnamed: C45.1, U6.6 (CPL)
unnamed: C46.1, R41.2, U6.3 (FB_BK)
unnamed: R49.1, R50.1, U6.36 (GAIN)
unnamed: R42.1, U6.33 (MODE)
unnamed: R47.2, R48.1, U6.35 (OCP/SR)
unnamed: R51.1, R52.1, U6.34 (SLEW)
unnamed: R43.1, U6.40 (SOA)
unnamed: R44.1, U6.39 (SOB)
unnamed: R45.1, U6.38 (SOC)
unnamed: R41.1, U6.5 (SW_BK)
PWM_A: U6.27 (INHA); also elsewhere on the board
PWM_B: U6.29 (INHB); also elsewhere on the board
PWM_C: U6.31 (INHC); also elsewhere on the board
nFAULT: R46.2, U6.22 (nFAULT); also elsewhere on the board
nSLEEP: U6.23 (nSLEEP); also elsewhere on the board

Notes on the sheet:
R47/R48 只贴一个
DRV8316C 配置电阻作用 (硬件配置版, 手册 SLVSH07 四电平输入表)
R42 47k MODE(33) -> AVDD : 3x PWM 模式, 本板已装
(该脚焊 0R 会进 3x+限流模式, SOx 不可用, 本板禁止)
R49 47k GAIN(36) -> AVDD : CSA 增益 0.6 V/A, 本板不装
R50 0R GAIN(36) -> AGND : CSA 增益 0.15 V/A, 本板不装
R49/R50 都不装 = 悬空 = 0.3 V/A (本板现状)
R51 47k SLEW(34) -> AVDD : 压摆率 125 V/us, 本板不装
R52 0R SLEW(34) -> AGND : 压摆率 25 V/us, 本板不装
R51/R52 都不装 = 悬空 = 50 V/us (本板现状)
R47 0R OCP/SR(35) -> AGND : OCP 16 A typ (10~22 A), 本板已装
R48 0R OCP/SR(35) -> AVDD : OCP 24 A typ (15~30 A), 本板不装
R47/R48 同时装 = AGND 与 AVDD 短路, 禁止
另: buck R_BK = R41 22R (SW_BK -> FB_BK), C_BK = C46 22uF/10V
VREF/ILIM(37) = +3V3 -> 中点 VREF/2 ; SOx = VREF/2 +/- GAIN x IOUT
VSEL_BK(24) = AGND -> buck 3.3V

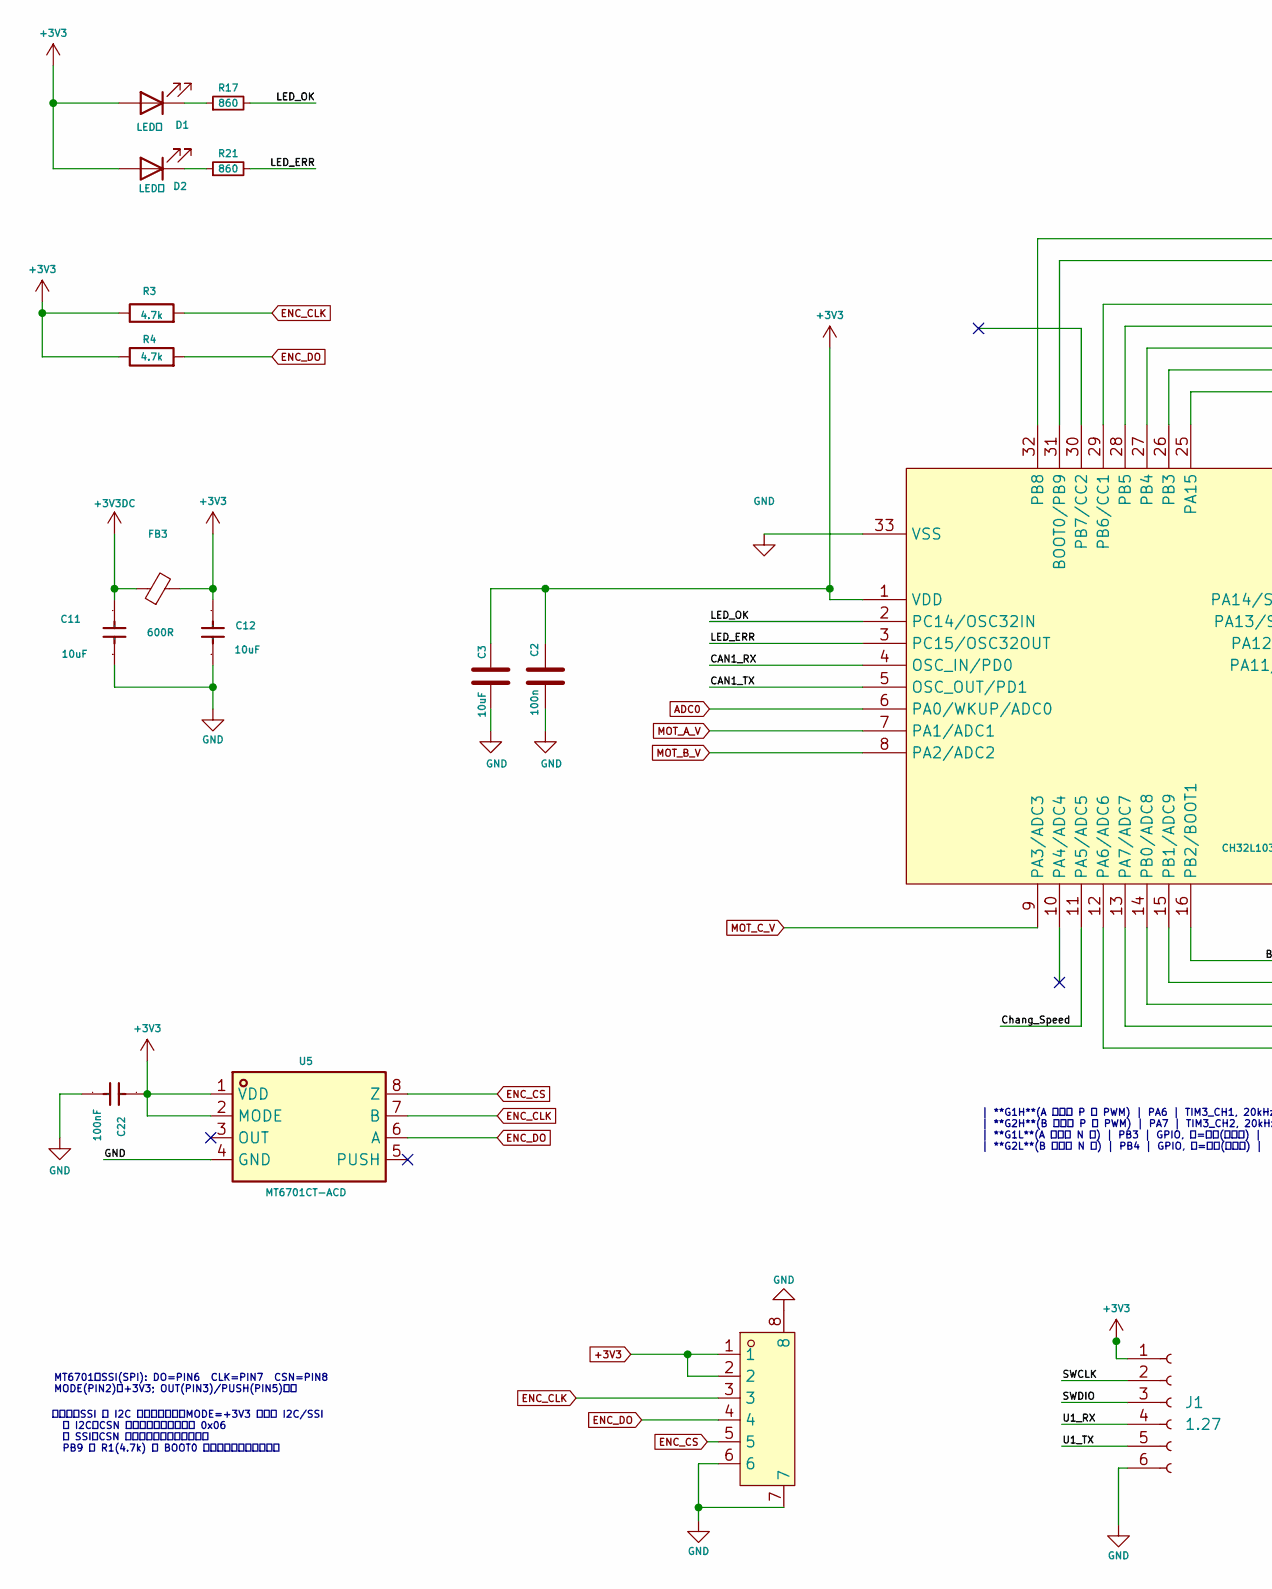
[picture p9: schematic CH32L103.kicad_sch, part in row 1, column 1]

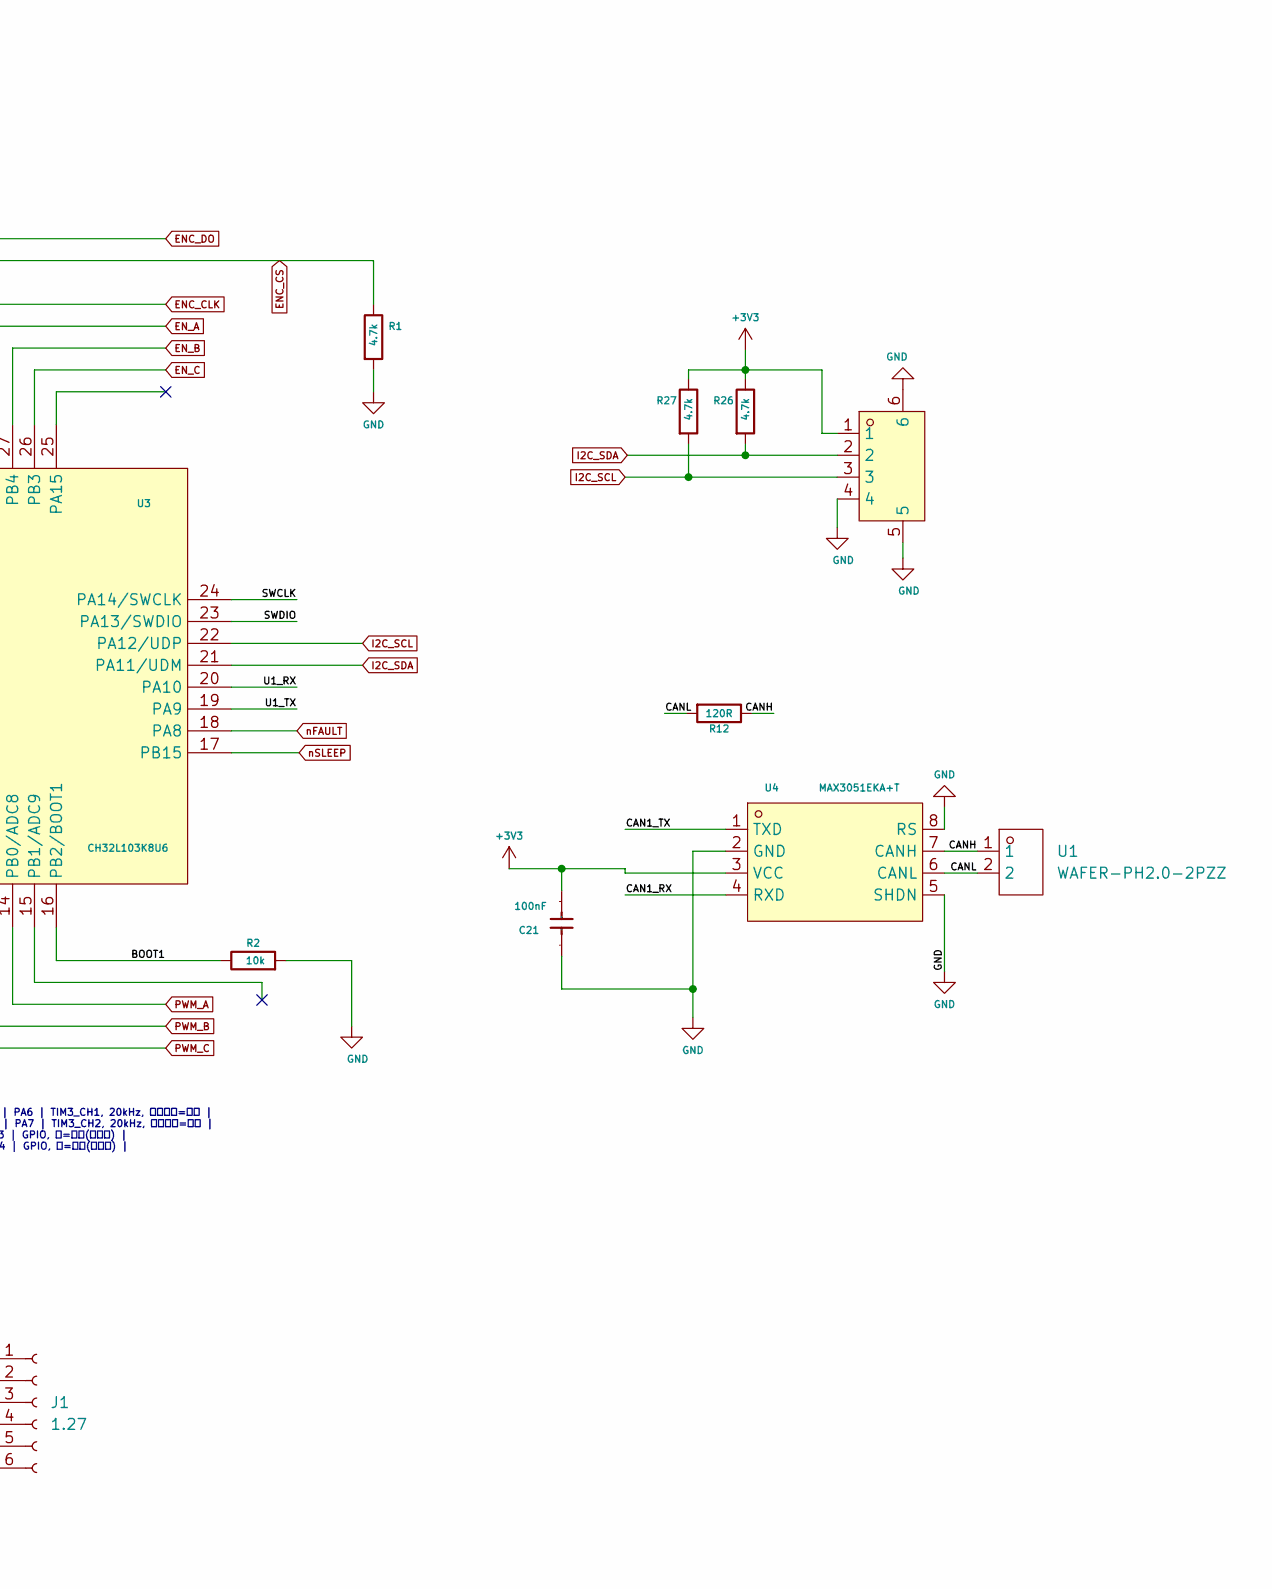
[picture p10: schematic CH32L103.kicad_sch, part in row 1, column 2]

Parts:
C2: 100n; C_0603_1608Metric
C3, C11, C12: 10uF; C_0603_1608Metric
C21, C22: 100nF; C_0603_1608Metric
D1: LED绿; LED_0603_GREEN
D2: LED红; LED_0603_RED
FB3: 600R; L_0603_1608Metric
J1: 1.27; PinHeader_1x06_P1.27mm_Vertical
J6: WAFER-MX1.25-4PCB; CONN-SMD_4P-P1.25_XUNPU_WAFER-MX1.25-4PCB; MPN WAFER-MX1.25-4PCB; LCSC Part C3029388
J11: FH34SRJ-6S-0.5SH; FFC-SMD_6P-P0.50_FH34SRJ-6S-0.5SH; MPN FH34SRJ-6S-0.5SH(50); LCSC Part C224194
R1, R3, R4, R26, R27: 4.7k; R_0603_1608Metric
R2: 10k; R_0603_1608Metric
R12: 120R; R_0805_2012Metric
R17, R21: 860; R_0603_1608Metric
U1: WAFER-PH2.0-2PZZ; CONN-TH_2P-P2.00_HC-PH-2A-M; CURRENT RATING 2A; VOLTAGE RATING 250V; MANUFACTURER PART WAFER-PH2.0-2PZZ; LCSC PART NAME 1x2P 间距:2mm 直插 系列:PH
U3: CH32L103K8U6; QFN-32-1EP_4x4mm_P0.4mm_EP2.65x2.65mm
U4: MAX3051EKA+T; SOT-23-8
U5: MT6701CT-ACD; SOIC-8_3.9x4.9mm_P1.27mm

Connections:
+3V3: C2.1, C3.1, C12.2, C21.1, C22.2, D1.2 (A), D2.2 (A), FB3.2, J1.1, J6.1, J11.1, J11.2, R3.1, R4.1, R26.1, R27.1, U3.1 (VDD), U4.3 (VCC), U5.1 (VDD), U5.2 (MODE); also elsewhere on the board
+3V3DC: C11.2, FB3.1; also elsewhere on the board
/CH32L103/BOOT1: R2.1, U3.16 (PB2/BOOT1)
/CH32L103/CAN1_RX: U3.4 (OSC_IN/PD0), U4.4 (RXD)
/CH32L103/CAN1_TX: U3.5 (OSC_OUT/PD1), U4.1 (TXD)
/CH32L103/CANH: R12.1, U1.1, U4.7 (CANH)
/CH32L103/CANL: R12.2, U1.2, U4.6 (CANL)
/CH32L103/Chang_Speed: U3.11 (PA5/ADC5)
/CH32L103/LED_ERR: R21.2, U3.3 (PC15/OSC32OUT)
/CH32L103/LED_OK: R17.2, U3.2 (PC14/OSC32IN)
/CH32L103/SWCLK: J1.2, U3.24 (PA14/SWCLK)
/CH32L103/SWDIO: J1.3, U3.23 (PA13/SWDIO)
/CH32L103/U1_RX: J1.4, U3.20 (PA10)
/CH32L103/U1_TX: J1.5, U3.19 (PA9)
ADC0: U3.6 (PA0/WKUP/ADC0); also elsewhere on the board
ENC_CLK: J11.3, R3.2, U3.29 (PB6/CC1), U5.7 (B)
ENC_CS: J11.5, R1.1, U3.31 (BOOT0/PB9), U5.8 (Z)
ENC_DO: J11.4, R4.2, U3.32 (PB8), U5.6 (A)
EN_A: U3.28 (PB5); also elsewhere on the board
EN_B: U3.27 (PB4); also elsewhere on the board
EN_C: U3.26 (PB3); also elsewhere on the board
GND: C2.2, C3.2, C11.1, C12.1, C21.2, C22.1, J1.6, J6.4, J6.5, J6.6, J11.6, J11.7, J11.8, R1.2, R2.2, U3.33 (VSS), U4.2 (GND), U4.5 (SHDN), U4.8 (RS), U5.4 (GND); also elsewhere on the board
I2C_SCL: J6.3, R27.2, U3.22 (PA12/UDP)
I2C_SDA: J6.2, R26.2, U3.21 (PA11/UDM)
MOT_A_V: U3.7 (PA1/ADC1); also elsewhere on the board
MOT_B_V: U3.8 (PA2/ADC2); also elsewhere on the board
MOT_C_V: U3.9 (PA3/ADC3); also elsewhere on the board
unnamed: D1.1 (K), R17.1
unnamed: D2.1 (K), R21.1
PWM_A: U3.14 (PB0/ADC8); also elsewhere on the board
PWM_B: U3.13 (PA7/ADC7); also elsewhere on the board
PWM_C: U3.12 (PA6/ADC6); also elsewhere on the board
nFAULT: U3.18 (PA8); also elsewhere on the board
nSLEEP: U3.17 (PB15); also elsewhere on the board

Notes on the sheet:
MT6701走SSI(SPI): DO=PIN6 CLK=PIN7 CSN=PIN8 MODE(PIN2)接+3V3; OUT(PIN3)/PUSH(PIN5)不用
| **G1H**(A 相上管 P 栅 PWM) | PA6 | TIM3_CH1, 20kHz, 有效电平=导通 | | **G2H**(B 相上管 P 栅 PWM) | PA7 | TIM3_CH2, 20kHz, 有效电平=导通 | | **G1L**(A 相下管 N 栅) | PB3 | GPIO, 高=导通(默认低) | | **G2L**(B 相下管 N 栅) | PB4 | GPIO, 高=导通(默认低) |
编码器：SSI 与 I2C 共用同一对线，MODE=+3V3 已选定 I2C/SSI 走 I2C：CSN 需全程拉高，从机地址 0x06 走 SSI：CSN 当片选，需拉高再拉低成帧 PB9 的 R1(4.7k) 是 BOOT0 必需下拉，不是片选偏置

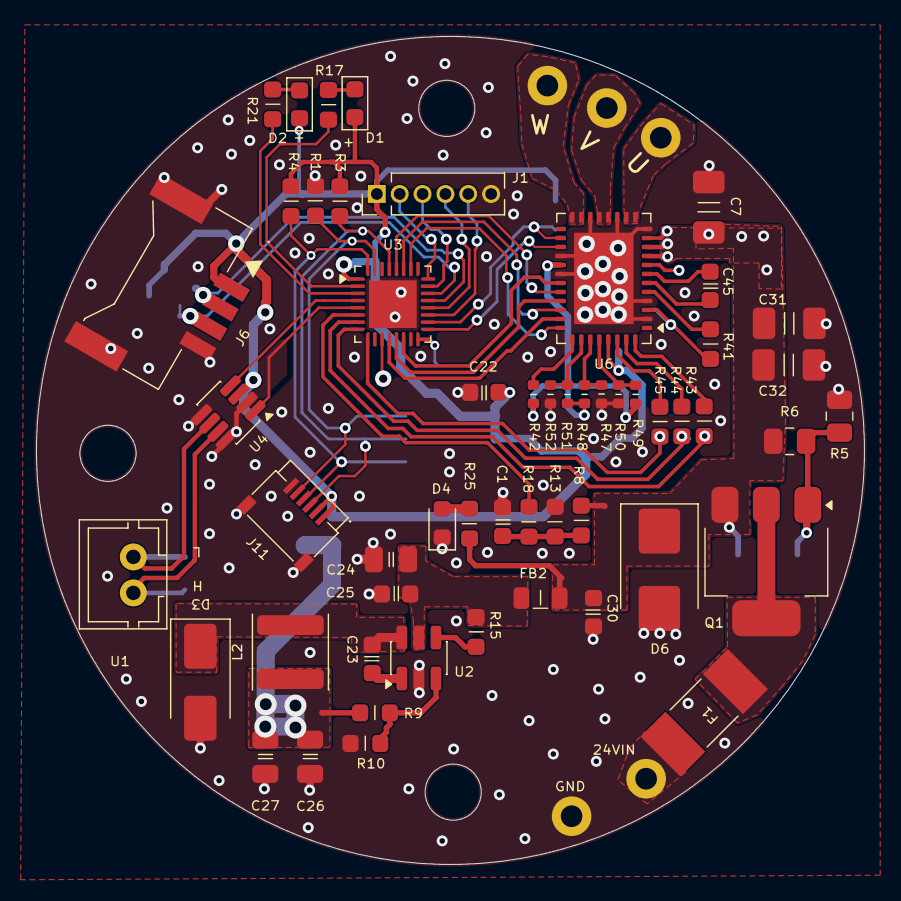
[picture p11: board L103_DRV8316C.kicad_pcb from above]

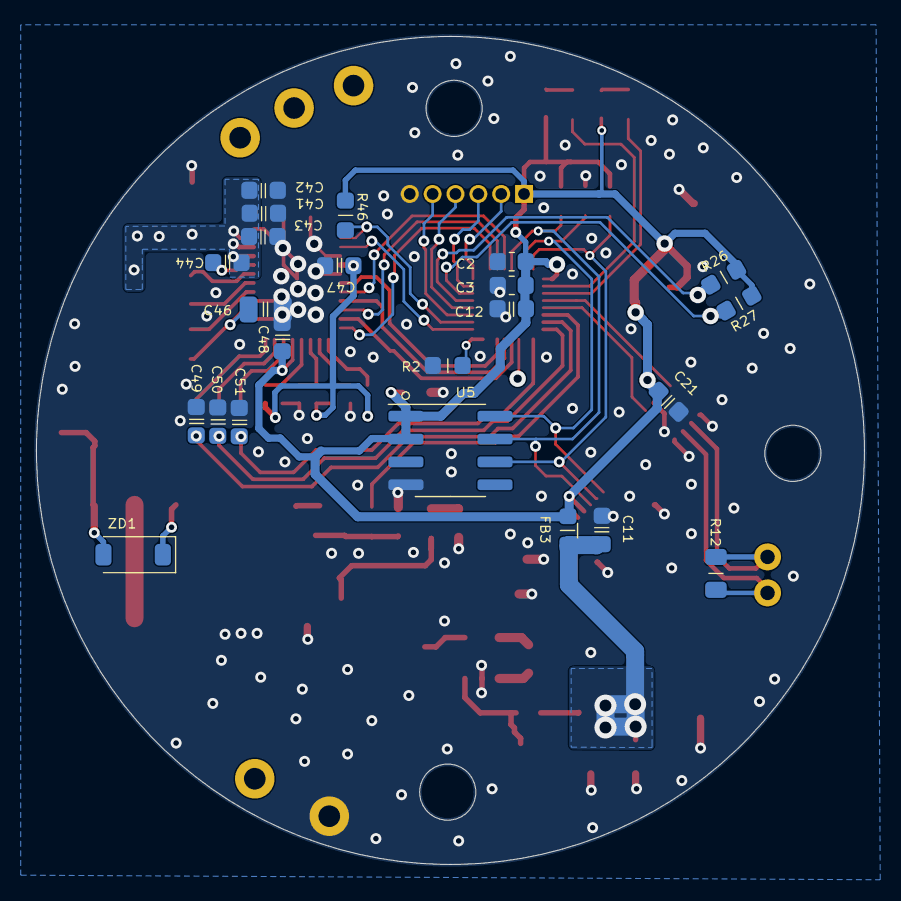
[picture p12: board L103_DRV8316C.kicad_pcb from below]

Board: 2 copper layers, 46.0 x 46.0 mm, 82 parts (23 on the bottom side), 60 nets.
