bjthemost-hub/l103-drv8316c-joint/firmware/User/foc_math_tab.h

/* 自动生成, 不要手改!  生成器: scripts\gen_sin_table.py
 * 256 点正弦表, 覆盖 [0, 2*pi), 线性插值。
 * 线性插值最大误差 = (2*pi/256)^2/8 = 7.530e-05 rad (算术值)
 * 覆盖到 N+1 项, 末项重复首项, 省掉查表时的回绕判断。 */
#ifndef __FOC_MATH_TAB_H
#define __FOC_MATH_TAB_H

#define SIN_TAB_N   256u
static const float sin_tab[SIN_TAB_N + 1u] = {
    +0.000000000e+00f,
    +2.454122852e-02f,
    +4.906767433e-02f,
    +7.356456360e-02f,
    +9.801714033e-02f,
    +1.224106752e-01f,
    +1.467304745e-01f,
    +1.709618888e-01f,
    +1.950903220e-01f,
    +2.191012402e-01f,
    +2.429801799e-01f,
    +2.667127575e-01f,
    +2.902846773e-01f,
    +3.136817404e-01f,
    +3.368898534e-01f,
    +3.598950365e-01f,
    +3.826834324e-01f,
    +4.052413140e-01f,
    +4.275550934e-01f,
    +4.496113297e-01f,
    +4.713967368e-01f,
    +4.928981922e-01f,
    +5.141027442e-01f,
    +5.349976199e-01f,
    +5.555702330e-01f,
    +5.758081914e-01f,
    +5.956993045e-01f,
    +6.152315906e-01f,
    +6.343932842e-01f,
    +6.531728430e-01f,
    +6.715589548e-01f,
    +6.895405447e-01f,
    +7.071067812e-01f,
    +7.242470830e-01f,
    +7.409511254e-01f,
    +7.572088465e-01f,
    +7.730104534e-01f,
    +7.883464276e-01f,
    +8.032075315e-01f,
    +8.175848132e-01f,
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
};

/* 1.0f / (2*pi) —— 角度 -> 表索引 的乘法倒数 */
#define SIN_TAB_INV_TWO_PI   1.591549431e-01f

#endif
