bjthemost-hub/l103-drv8316c-joint/firmware/User/foc_tab_q15.h

/* 自动生成, 不要手改! 生成器: scripts\gen_foc_tab.py
 * 1024 点 int16 Q15 正弦表, 索引 = (uint16 电角度) >> 6。
 * 最近点取样最大误差 3.07e-3 rad (0.176 电角度), 对电流环可忽略。
 * 表长 1024*2B = 2 KiB, const -> Flash。*/
#ifndef __FOC_TAB_Q15_H
#define __FOC_TAB_Q15_H

#include <stdint.h>

#define FOC_TAB_N     1024u
#define FOC_TAB_SHIFT 6u

static const int16_t foc_sin_q15[FOC_TAB_N] = {
     0,    201,    402,    603,    804,   1005,   1206,   1407,   1608,   1809,   2009,   2210,
  2410,   2611,   2811,   3012,   3212,   3412,   3612,   3811,   4011,   4210,   4410,   4609,
  4808,   5007,   5205,   5404,   5602,   5800,   5998,   6195,   6393,   6590,   6786,   6983,
  7179,   7375,   7571,   7767,   7962,   8157,   8351,   8545,   8739,   8933,   9126,   9319,
  9512,   9704,   9896,  10087,  10278,  10469,  10659,  10849,  11039,  11228,  11417,  11605,
 11793,  11980,  12167,  12353,  12539,  12725,  12910,  13094,  13279,  13462,  13645,  13828,
 14010,  14191,  14372,  14553,  14732,  14912,  15090,  15269,  15446,  15623,  15800,  15976,
 16151,  16325,  16499,  16673,  16846,  17018,  17189,  17360,  17530,  17700,  17869,  18037,
 18204,  18371,  18537,  18703,  18868,  19032,  19195,  19357,  19519,  19680,  19841,  20000,
 20159,  20317,  20475,  20631,  20787,  20942,  21096,  21250,  21403,  21554,  21705,  21856,
 22005,  22154,  22301,  22448,  22594,  22739,  22884,  23027,  23170,  23311,  23452,  23592,
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
 11039,  10849,  10659,  10469,  10278,  10087,   9896,   9704,   9512,   9319,   9126,   8933,
  8739,   8545,   8351,   8157,   7962,   7767,   7571,   7375,   7179,   6983,   6786,   6590,
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
};

#endif
