bjthemost-hub/l103-drv8316c-joint/(commit log)

2026-10-27 Initial commit: CH32L103 + DRV8316C FOC joint motor driver (hardware / firmware / GUI / 2-stage planetary gearbox)
    [00_assembly.step, 00_assembly.stl, 03_input_sun_gear_only.step, 03_input_sun_gear_only.stl, 03_input_sun_gear_only_D5.step, 03_input_sun_gear_only_D5.stl, 03_input_sun_gear_only_solid.step, 03_input_sun_gear_only_solid.stl]
2026-10-27 docs: add English README and language switch
2026-10-27 Add 8316C demo video; gearbox: STEP only; move GUI to its own repo
    [00_assembly.step, 00_assembly.stl, 01_ring_gear.step, 02_planet_gear.step, 03_input_sun.step, 03_input_sun_gear_only.step, 03_input_sun_gear_only.stl, 03_input_sun_gear_only_D5.step]
